simonwendel/sun-to-usb-adapter/src/hardware/IInterruptsControl.h

/*
 * Sun to USB keyboard adapter
 * Copyright (C) 2019  Simon Wendel
 *
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
 * You should have received a copy of the GNU General Public License
 * along with this program.  If not, see <http://www.gnu.org/licenses/>.
 */

#pragma once

namespace hardware
{
    class IInterruptsControl
    {
    public:
        virtual void disableInterrupts() = 0;
        virtual void enableInterrupts() = 0;
    };
} // namespace hardware
