simonwendel/sun-to-usb-adapter/test/adapter/ProgramTests.cpp

/*
 * Sun to USB keyboard adapter
 * Copyright (C) 2019  Simon Wendel
 *
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
 * You should have received a copy of the GNU General Public License
 * along with this program.  If not, see <http://www.gnu.org/licenses/>.
 */

#include "../../src/adapter/HidCode.h"
#include "../../src/adapter/HidUsageCode.h"
#include "../../src/adapter/ISetting.h"
#include "../../src/adapter/Program.h"
#include "../../src/adapter/Translation.h"
#include "../mocks/adapter/MockIFlashingLight.h"
#include "../mocks/adapter/MockILedChecker.h"
#include "../mocks/adapter/MockILog.h"
#include "../mocks/adapter/MockIScanCodeTranslator.h"
#include "../mocks/adapter/MockISetting.h"
#include "../mocks/adapter/MockISunKeyboard.h"
#include "../mocks/adapter/MockIUsbKeyboard.h"

#include <arduino-platform.h>
#include <gmock/gmock.h>
#include <gtest/gtest.h>

namespace adapter_tests
{
    using namespace testing;

    class adapter_Program : public Test
    {
    public:
        int invalidCode = 137;
        adapter::Translation invalidTranslation =
        adapter::Translation::makeInvalid();

        int validCode = 110;
        adapter::Translation validTranslation =
        adapter::Translation::makeValid(adapter::HidCode{});

        float errorFrequencyHz = 2;
        float ledCheckingIntervalHz = 20;

        adapter::LedConfiguration leds;

        adapter_mocks::MockISetting keyboardClicks;
        adapter_mocks::MockISetting checkLeds;
        adapter_mocks::MockISunKeyboard sunKeyboard;
        adapter_mocks::MockIUsbKeyboard usbKeyboard;
        adapter_mocks::MockILog log;
        adapter_mocks::MockIScanCodeTranslator translator;
        adapter_mocks::MockIFlashingLight errorIndicator;
        adapter_mocks::MockILedChecker ledChecker;

        adapter::Program sut{&log,
                             &keyboardClicks,
                             &checkLeds,
                             &sunKeyboard,
                             &usbKeyboard,
                             &translator,
                             &errorIndicator,
                             &ledChecker};

        adapter_Program()
        {
            ON_CALL(sunKeyboard, read()).WillByDefault(Return(invalidCode));

            ON_CALL(translator, translate(invalidCode))
            .WillByDefault(Return(invalidTranslation));

            ON_CALL(translator, translate(validCode))
            .WillByDefault(Return(validTranslation));
        }
    };

    TEST_F(adapter_Program, setup_GivenKeyboardClickSetting_ReadsSetting)
    {
        EXPECT_CALL(keyboardClicks, isOn());
        sut.setup();
    }

    TEST_F(adapter_Program,
           setup_GivenKeyboardClickSettingIsOn_TurnsOnKeyboardClicks)
    {
        ON_CALL(keyboardClicks, isOn()).WillByDefault(Return(true));
        EXPECT_CALL(sunKeyboard, turnOnClicks());
        sut.setup();
    }

    TEST_F(adapter_Program,
           setup_GivenKeyboardClickSettingIsOff_DoesNotTurnOnKeyboardClicks)
    {
        ON_CALL(keyboardClicks, isOn()).WillByDefault(Return(false));
        EXPECT_CALL(sunKeyboard, turnOnClicks()).Times(Exactly(0));
        sut.setup();
    }

    TEST_F(adapter_Program,
           setup_GivenCheckLedsSettingIsOff_DoesNotTurnOnLedChecker)
    {
        ON_CALL(checkLeds, isOn()).WillByDefault(Return(false));
        EXPECT_CALL(ledChecker, startChecking(_)).Times(Exactly(0));
        sut.setup();
    }

    TEST_F(adapter_Program,
           setup_GivenCheckLedsSettingIsOn_TurnsOnLedChecker)
    {
        ON_CALL(checkLeds, isOn()).WillByDefault(Return(true));
        EXPECT_CALL(ledChecker, startChecking(ledCheckingIntervalHz)).Times(Exactly(1));
        sut.setup();
    }

    TEST_F(adapter_Program, setup_WhenSetupCompletes_LogsInfoMessage)
    {
        String message{"Setup completed."};

        Expectation clicksSetup = EXPECT_CALL(keyboardClicks, isOn());
        Expectation numLockSetup = EXPECT_CALL(checkLeds, isOn());

        EXPECT_CALL(log, info(message)).After(clicksSetup, numLockSetup);

        sut.setup();
    }

    TEST_F(adapter_Program, loop_WhenFirstCalled_LogsInfoMessage)
    {
        String message{"Adapter started."};
        EXPECT_CALL(log, info(message));
        sut.loop();
    }

    TEST_F(adapter_Program, loop_WhenLaterCalled_DoesntLogInfoMessageAgain)
    {
        EXPECT_CALL(log, info(_)).Times(1);

        sut.loop();
        sut.loop();
        sut.loop();
        sut.loop();
    }

    TEST_F(adapter_Program, loop_WhenReadingFromSerialPort_AttemptsTranslation)
    {
        ON_CALL(sunKeyboard, read()).WillByDefault(Return(validCode));
        EXPECT_CALL(translator, translate(validCode));
        sut.loop();
    }

    TEST_F(
    adapter_Program,
    loop_WhenTranslationFailsAndErrorIndicatorFlashing_DoesNotStartFlashing)
    {
        ON_CALL(errorIndicator, isFlashing()).WillByDefault(Return(true));
        EXPECT_CALL(errorIndicator, startFlashing(errorFrequencyHz)).Times(0);
        sut.loop();
    }

    TEST_F(adapter_Program,
           loop_WhenTranslationFailsAndErrorIndicatorNotFlashing_StartsFlashing)
    {
        ON_CALL(errorIndicator, isFlashing()).WillByDefault(Return(false));
        EXPECT_CALL(errorIndicator, startFlashing(errorFrequencyHz));
        sut.loop();
    }

    TEST_F(adapter_Program, loop_WhenTranslationFails_DoesNotEmitHidCode)
    {
        EXPECT_CALL(usbKeyboard, emit(_)).Times(0);
        sut.loop();
    }

    TEST_F(adapter_Program, loop_WhenTranslationSucceeds_EmitsHidCode)
    {
        ON_CALL(sunKeyboard, read()).WillByDefault(Return(validCode));
        EXPECT_CALL(usbKeyboard, emit(validTranslation.getHidCode()));
        sut.loop();
    }
} // namespace adapter_tests
