simonwendel/sun-to-usb-adapter/test/adapter/SunKeyboardTests.cpp

/*
 * Sun to USB keyboard adapter
 * Copyright (C) 2019  Simon Wendel
 *
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
 * You should have received a copy of the GNU General Public License
 * along with this program.  If not, see <http://www.gnu.org/licenses/>.
 */

#include "../../src/adapter/Command.h"
#include "../../src/adapter/LedConfiguration.h"
#include "../../src/adapter/SunKeyboard.h"
#include "../mocks/hardware/MockISerialPort.h"

#include <arduino-platform.h>
#include <gmock/gmock.h>
#include <gtest/gtest.h>

namespace adapter_tests
{
    using namespace testing;

    class adapter_SunKeyboard : public Test
    {
    public:
        const int SERIAL_RATE = 1200;
        hardware_mocks::MockISerialPort serialPort;
        adapter::SunKeyboard sut{&serialPort};
    };

    TEST_F(adapter_SunKeyboard,
           constructor_GivenSerialPort_OpensPortWithDefaultSpeed)
    {
        Mock::VerifyAndClear(&serialPort);
        EXPECT_CALL(serialPort, begin(SERIAL_RATE)).Times(1);
        adapter::SunKeyboard sut{&serialPort};
    }

    TEST_F(adapter_SunKeyboard,
           turnOnClicks_GivenSerialPort_SendsEnableClickCommand)
    {
        auto expectedCommand = adapter::Command::ENABLE_CLICK;
        EXPECT_CALL(serialPort, write(expectedCommand));
        sut.turnOnClicks();
    }

    TEST_F(adapter_SunKeyboard,
           turnOffClicks_GivenSerialPort_SendsDisableClickCommand)
    {
        auto expectedCommand = adapter::Command::DISABLE_CLICK;
        EXPECT_CALL(serialPort, write(expectedCommand));
        sut.turnOffClicks();
    }

    TEST_F(adapter_SunKeyboard,
           turnOnBell_GivenSerialPort_SendsEnableBellCommand)
    {
        auto expectedCommand = adapter::Command::ENABLE_BELL;
        EXPECT_CALL(serialPort, write(expectedCommand));
        sut.turnOnBell();
    }

    TEST_F(adapter_SunKeyboard,
           turnOffBell_GivenSerialPort_SendsDisableBellCommand)
    {
        auto expectedCommand = adapter::Command::DISABLE_BELL;
        EXPECT_CALL(serialPort, write(expectedCommand));
        sut.turnOffBell();
    }

    TEST_F(adapter_SunKeyboard,
           setLeds_GivenLedConfiguration_WritesSequenceToSerialPort)
    {
        adapter::LedConfiguration leds;
        leds.setNumLock();
        leds.setScrollLock();

        uint8_t expectedSequence[] = {adapter::Command::SET_LEDS, leds};

        auto verifySequence = [expectedSequence](const uint8_t *actualSequence,
                                                 const uint8_t size) {
            EXPECT_EQ(size, 2);
            for (size_t i = 0; i < size; ++i)
            {
                EXPECT_EQ(expectedSequence[i], actualSequence[i]);
            }
        };

        EXPECT_CALL(serialPort, write(_, 2))
        .WillOnce(DoAll(Invoke(verifySequence), Return(2)));

        sut.setLeds(leds);
    }

    TEST_F(adapter_SunKeyboard, read_WhenPortHasValidValue_ReturnsThatValue)
    {
        auto expected = 120;
        EXPECT_CALL(serialPort, read()).WillOnce(Return(expected));

        auto actual = sut.read();
        EXPECT_EQ(actual, expected);
    }

    TEST_F(adapter_SunKeyboard,
           read_WhenPortHasInvalidValues_WaitsUntilValidToReturn)
    {
        auto invalidLow = 0;
        auto invalidHigh = 256;
        auto expected = 120;

        EXPECT_CALL(serialPort, read())
        .WillOnce(Return(invalidLow))
        .WillOnce(Return(invalidHigh))
        .WillOnce(Return(expected));

        auto actual = sut.read();
        EXPECT_EQ(actual, expected);
    }
} // namespace adapter_tests
