simonwendel/sun-to-usb-adapter/(commit log)

2018-02-19 Change the source for Arduino micro clone
2018-02-19 Add keyboard firmware
    I liked to use all special keys from the keyboard, but the original
    HID Library does not support a bunch of Special Keys. I found the
    HID-Project and implemented the missing keys. But there is one big
    issue, the sun_keyboard_map has to be rewritten to support the special
    key codes, But I was to lazy to look at this issue, at the end I
    implemented the Function directly and use the header only for the
    not hard coded keys. It could be better, but for the first stage it
    works and I currently wirting the commit message on the sun type 5
    Keyboard.
    This Version supports some of the functions on the left side, but
    only on mac os x. A Windows Version is not planed.
    [sun_keyboard_map.h]
2018-07-06 Fixing Numlock LED
    The LED is now toggeling
2019-05-06 feat: use correct serial pins on board
    [sun-usb-adapter.ino]
2019-05-06 feat: switch keystroke debugger to correct pins
2019-05-06 fix: make structure sketchbooklike again
    [sun-serial-keystroke-debugger.ino, sun-usb-adapter.ino, sun_keyboard_map.h]
2019-05-07 style: whitespace fixes in board_config.h
    [board_config.h]
2019-05-12 feat: convert project to Arduino.mk instead of pio
2019-05-15 docs: update README to reflect my board
2019-05-15 style: remove redundant pin and board comments
2019-05-15 docs: cache connector diagram from kbdbabel.org
2019-05-20 feat: stub Arduino.h for compiling on non-AVR host
2019-05-20 feat: wrap Arduino pin operations with interface
2019-05-20 feat: add an IInputPin for reading pin states
2019-05-22 fix: broken tool build due to missing declarations
    [find-missing-scancodes.cpp]
2019-05-22 feat: add test for dipswitch and pulldown resistor
2019-05-22 feat: add IOutputPin for writing pin states
2019-05-24 docs: add schematic of the complete circuit
2019-05-24 docs: remove wiring colors, they don't add value
2019-05-25 fix: add pragma once to header file
    [PinControl.h]
2019-05-25 style: fix some whitespace and include ordering
    [IInputPin.h, InputPin.cpp]
2019-05-27 fix: rm virtual dtors, avr lacks support
    The AVR GCC doesn't properly implement some new and delete opers,
    because of hardware limitations. Removing virtual destructors
    rids us of the pain.
    [IInputPin.h, IOutputPin.h, IPinControl.h, ISerialPort.h, ISetting.h]
2019-05-28 feat: switch to using ptrs instead of refs
2019-05-28 fact: alter dip switch test to use new stuff
2019-05-29 feat: add a main entrypoint for the arduino
2019-05-30 chore: arrange test fixtures and mocks in subdirs
    [MockIInputPin.h, ProgramTests.cpp, SettingTests.cpp]
2019-05-30 feat: stub WString.h from the Wiring lib
2019-05-30 fix: include Program.h from correct dir
    [entrypoint.cpp]
2019-06-01 fact: fix some old includes to arduino-platform.h
    [InputPin.cpp, OutputPin.cpp]
2019-06-01 feat: stub out the Print.h chain a bit
2019-06-01 feat: add print and println to ISerialPort
2019-06-04 feat: add enum class for timer1 prescaler values
2019-06-04 fix: patch main project makefile to include timers
2019-06-04 feat: add value object for CTC mode timer settings
2019-06-04 feat: add calculator for timer1 CTC mode settings
2019-06-06 fact: simplify some test fixtures and methods
    [SettingTests.cpp]
2019-06-06 feat: add control of interrupts
2019-06-08 chore: include stubbed arduino libs in vscode conf
2019-06-08 style: switch to uniform initialization in ctors
2019-06-09 feat: stub out some things related to 16bit Timer1
2019-06-09 style: namespace annotations fixed in mocks
    [MockIInputPin.h]
2019-06-09 feat: add abstraction over 16bit Timer1
2019-06-12 feat: add a timer based error indicator
2019-06-12 feat: have Log light the error indicator on error
    [Log.cpp, LogTests.cpp]
2019-06-15 feat: add a test over second dip-switch channel
2019-06-15 fix: remove dtor from Register failing build
    [Register.h]
2019-06-15 feat: add ICTCTimer and CTCTimer1 timer functions
2019-06-16 docs: add the second dip-swith channel wiring
2019-06-30 feat: add class to compute the LED command payload
2019-07-01 fact: ErrorIndicator into generic FlashingLight
    [FlashingLight.cpp, FlashingLight.h, FlashingLightTests.cpp, IFlashingLight.h]
2019-07-01 fact: rename LedCommandPayload -> LedCommand
2019-07-04 feat: add LED setting to keyboard commander
2019-07-05 feat: add operator== overload to LedCommand refs
2019-07-05 docs: fix wording whether timer calcs are included
2019-07-05 docs: add NumLock to the section on DIP-switches
2019-08-31 fix: broken old tool that won't build
    [board_config.h, simple-serial-print.cpp, sun_keyboard_map.h]
2019-10-16 fix: update entrypoint headers after refactoring
    [entrypoint.cpp]
2019-10-16 feat: create an isolated dev container for the build chain
2019-10-16 fix: remove absolute path to arduino-platform.h
    [Setting.cpp]
2019-10-16 feat: add arduino cli to dev container
2019-10-26 style: fix typo in pair of test method names
    [HidCodeTests.cpp]
2019-10-26 feat: use IToggle to flash on FlashingLight timer event
2019-10-26 feat: add method to reset a Toggle
    [IToggle.h, Toggle.cpp, Toggle.h, ToggleTests.cpp]
2019-10-26 fix: move make variables into Arduino.mk scope
2019-10-27 feat: modify serial print to debug key presses -> sun codes
2019-10-27 docs: add rough map of swe keycaps sun kbd -> hid usage codes
    [swe_sun_to_hid.xlsx]
2019-10-28 docs: fill in blanks in HID code map
    [swe_sun_to_hid.xlsx]
2019-11-02 feat: sort hid code spreadsheet
    [swe_sun_to_hid.xlsx]
2019-11-02 feat: add the scan code translation map
    This is skipped when building test fixtures because of tight dependency
    on Arduino.h
    [ScanCodeTranslationMap.cpp, ScanCodeTranslationMap.h]
2019-11-02 fact: rename LedCommand -> LedConfiguration
    This is technically speaking not a command, it is a configuration. :-)
2019-11-05 fix: faulty mapping of HID Return/Enter
    [ScanCodeTranslationMap.cpp]
2019-11-06 fact: promote LED state to field in Program class
2019-11-06 fact: extract LED conf magic numbers to constants
2019-11-06 feat: add method to toggle LED configurations
2019-11-09 fact: replace HID-Project constants with local ones
    [HidUsageCode.h, ScanCodeTranslationMap.cpp]
2019-11-09 fact: remove logging when translation fails
    [Program.cpp, ProgramTests.cpp]
2019-11-10 feat: add board config for the builtin LED
2019-11-10 fix: add begin to SerialMonitor
    [SerialMonitor.cpp, SerialMonitor.h]
2019-11-10 feat: toggle LEDs in main program
2019-11-10 feat: wire up stuff in the Arduino entrypoint
2019-11-13 feat: add CTC Timer 3
2019-11-13 fix: filter out the Sun "release all" code
    [Program.cpp, Translation.h]
2019-11-13 feat: remove the flashOnce method again
    This reverts commit 4cf0bbfd8c1ad38d842fa4c8bce6a316c6acc69d.
    [FlashingLight.cpp, FlashingLight.h, FlashingLightTests.cpp, IFlashingLight.h]
2019-11-13 feat: add conversion from USB LED states to Sun
2019-11-13 fix: remove pragma once from implementation file
    [LedConverter.cpp]
2019-11-13 feat: add a timer based thingie to query USB LEDs
2019-11-13 docs: set out plan for second DIP switch setting
2019-11-14 fix: include stdint.h for good measure
    [IUsbKeyboard.h]
2019-11-14 fix: actually save the state in the LED checker
    [LedChecker.cpp]
2019-11-14 feat: use LED checker to light appropriate LEDs
